spejderlasse/IOT/README.md

# IOT
Internet Of Things

## Purpose
Repository for the course E5IOT at Aarhus University, 2020.
This repository will contain sourcecode for the IOT project of Lasse Greve Rasmussen.
The project will be developed for a particle Argon.
The project is targeted a hen house, and the purpose is to set up a device to controle the gate  .

## Structure
There is two folders. One for the code, and one for appendixes.

## Tasks
- collect daily sunrise/sunset from an online service.
- by a servo close the door one hour after sunset.
- by a servo open the door at sunrise.
- allow a user to manually open or close the door.

## Documentation
The documentation will be in danish.

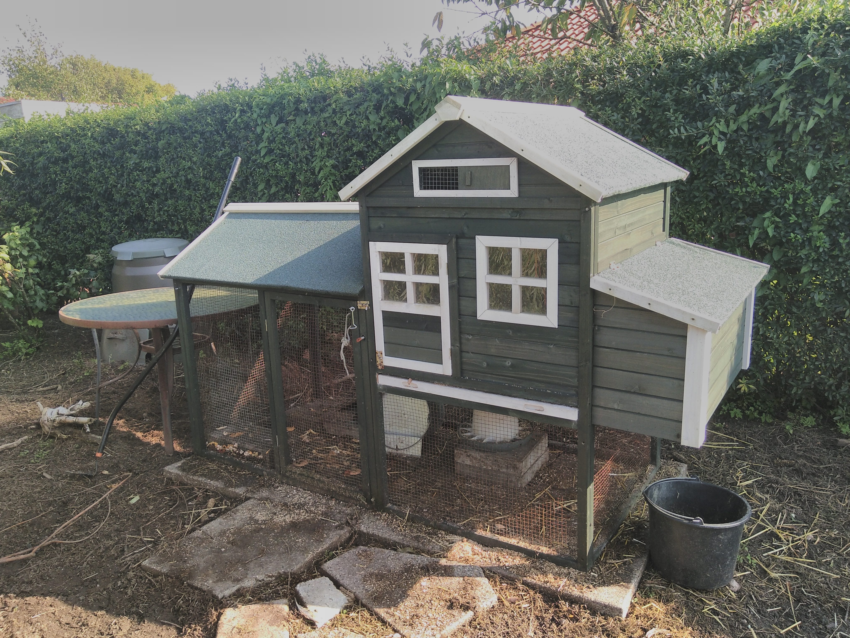
[picture p1: IMG_20200914_155222.jpg]


## Video Demonstration
https://youtu.be/oadeA-ce4zg
