spejderlasse/IOT/IOT_Dokumentation_01.docx

# E5IOT

# Internet of Things

# Automatisering af hønsehus

5. semester 2020

Science and Technology, Ingeniørhøjskolen, Aarhus Universitet, EDE, Herning

Deltagere
Studienummer | Navn | | Initialer
201808044 | Lasse Greve Rasmussen | | LGR
Undervisere: Morten Opprud Jakobsen Klaus Kolle

# Resume

Denne rapport gennemgår hvordan der er arbejdet med en IoT løsning til automatisering af døren i et hønsehus.

Rapporten beskriver analyse, design, implementering og verifikation af projektet.

# Forord

Denne rapport er dokumentation for det selvvalgte projekt der er arbejdet med under faget ’E5IOT’ der omhandler begrebet ’Internet Of Things’.

Hvem er jeg:

Lasse Greve Rasmussen

Uddannelsessted: Aarhus Universitet, Herning

Studieretning: Ingeniør - Elektronik

Semester: 5. semester

Underviser: Morten Opprud Jakobsen

Afleveringsdato: december 2020

Bedømmelsesdato: december 2020

## Begreber og forkortelser

Begreb | Definition
hønsehus | Hønsehuset består af selvehønsehuset samt en tilhørende lille hønsegård. Det er hele denne enhed der lukkes og åbnes for
Argon | Udviklingsboard fra Particle
IFTTT | Online service ‘If This Then That’ [05]

# Indledning

Formålet med denne opgave er at undersøge, hvordan man kan lave en internetforbundet løsning der automatiserer døren i et hønsehus. Løsningen skal kunne åbne døren ved solopgang, og efter solnedgang skal den lukke døren igen.

Høns er meget pålidelige i at de altid søger ind i deres hus når det begynder at blive mørkt. Det er derfor ikke nødvendigt at kontrollere om hønsene er inde, når blot man sikrer at lågen først lukkes efter at det er blevet mørkt.

Formålet med at holde hønsehuset lukket om natten, er at sikrer at der ikke kommer skadedyr i hønsenes foder.

Systemet skal være baseret på data om dagens solopgang og solnedgang der ligger online, så enheden der styrer systemet skal være forbundet til internettet.

# Analyse

For at klarlægge hvad systemet skal kunne er der lavet krav der definerer dette. Kravene er kategoriseret og formuleret efter EARS metoden.

## Krav

ufravigelige

- Systemet skal kontrollere en servomotor der kan åbne og lukke døren i et hønsehus.
- Systemet skal have informationer om solopgang og solnedgang via internettet.

Handling

- Når solen er stået op, skal lågen åbne.
- Når solen er gået ned, skal lågen lukke.

Tilstand

- Mens systemet ikke har nogle funktioner, skal systemet bruge så lidt strøm som muligt.

Uønsket adfærd

- Hvis der ikke er wififorbindelse, skal systemet styres ud fra lysmålinger målt med en photoresistor.

Valgfri

- Systemet kan indeholde styring af belysning i hønsehuset
- Systemet kan være drevet af et batteri der om dagen oplades af en solcelle

## Platform

Projektets krav til platform

- Minimum én ADC til photoresistor.
- Minimum én PWM udgang til at kontrollere servomotoren.
- Mulighed for internetforbindelse via WiFi.
- Systemet stiller ikke store krav indenfor proces og ressourcer.

Til faget er der anvendt en particle argon, der er en god platform med mange muligheder til IOT løsninger. Det vurderes at denne platform vil være god til projektet, da den overholder ovenstående krav til en platform.

I Figur 1 ses et overblik over en Particle Argon. Her ses at der er flere muligheder for både PWM og ADC, og boardet kan forbinde til internettet via WiFi. Particle Argon bygger på en 64MHz ARM Cortex-M4F 32-bit processor og har 1 MB flash, og 256 KB RAM [3]. Dette er rigeligt til de relativt simple opgaver der skal løses i dette projekt.


Figur 1 - pinout for Paricle Argon [03]

# Design

I dette afsnit vil de overordnede tanker om systemets design være beskrevet.

## modes

Systemet bygges op omkring tre modes;

- Normal: systemet afventer funktionskald fra IFTTT eller interrupt for manuel kontrol. Mens systemet er i normal, vil en tæller stå og tælle op. Hvis der går 20 timer uden kald fra IFTTT, antages det at der er sket en fejl, og systemet går i ’sensor control’.
- Sensor mode: dette er et sensorstyret mode, der fungere som fejlhåndtering. Systemet måler via photoresistor lysstyrke, og baseret på en midlet værdi vurderes om lågen skal åbnes eller lukkes. Dette fortsætter indtil der er blevet gennemført et online funktionskald.
- Manual mode: Med to trykknapper kan man manuelt åbne eller lukke lågen, hvis dette gøres, forbliver systemet i ’manual mode’ indtil en tredje trykknap for ’manual mode off’ aktiveres.

## Feedbacksignaler

For at give brugeren feedback er koden implementeret så forskellige farver viser hvilket mode der er aktivt.

- Normal: dioden lyser grøn som det er vist på Figur 8.
- Sensor control: dioden lyser rød for at indikere at der er ’fejl’ i systemet. Dioden lyser ikke konstant, da den vil være slukket under måling af lysniveau.
- Manual: dioden lyser blå.

## Aktivitetsdiagram

For at klarlægge handlinger i systemet laves der et aktivitetsdiagram. Aktivitetsdiagrammet består af en blanding af almindelige processer, og interrupt tyrede processer.


Figur 2 - aktivitetsdiagram

## Interface

Her ses det hvordan komponenterne i systemet skal forbindes.


## styring efter solopgang og solnedgang

For at styre lågen efter solopgang og solnedgang vælges det at anvende to services fra IFTTT.com. IFTTT står for If This Then That, og er en samling af mange services særligt til anvendelse for IOT enheder. Funktionerne kan kombineres, så man på baggrund af en hændelse kan få udført en anden.

Til at detektere solopgang og solnedgang anvendes services fra ’Weather Underground’ der giver signal ved henholdsvis solopgang og solnedgang. For solnedgang sættes lokationen til Dublin, for at sikre at alle hønsene når at komme ind. Indstillinger for sunset ses i Figur 3.

Particle har også en service der giver mulighed for at kalde en funktion på f.eks. en argon. Indstillinger for funktionskald ses i Figur 4.


Figur 3 - If -> sunset | Figur 4 - Then -> kald 'gate' med argumentet close

## Energiforbrug

For at systemet potentielt skal kunne drives af et batteri, er det vigtigt at det har et lavt strømforbrug. Den enhed der har det største strømforbrug er servomotoren. Målinger foretaget med 1 ohms modstand i serie med 5V forsyning (Figur 5), viser at denne kan have et forbrug på op mod 550 mA.

Et billede, der indeholder tekst Automatisk genereret beskrivelse

Figur 5 - opstilling til måling af systemets samlede strømforbrug

Servomotoren vil fast have dette høje strømforbrug, idet den konstant vil forsøge at fastholde sin position i target. Den eneste måde at stoppe dette er at afbryde forsyningen. Der sættes derfor en transistor som forbindelse mellem servomotorens stelledning, og GND på boardet. Denne transistor aktiveres af en GPIO sat som digitalt output.

Der vælges en BD135 NPN transistor der bl.a. har følgende egenskaber:

- Den kan trække op til 1.5 A på collector benet.
- Den har en forstærkning på mindst 25.
- BaseEmitter spænding op til 1 V

For at kunne trække en strøm på op til 600 mA med transistoren i satuation, skal base strømmen altså være mindst (550mA)/25=22 mA

Spændingsfald over basemodstanden vil mindst være 3.3V-1V=2.3 V

Dermed giver det en modstand på (2.3 V)/(22mA)= 104.5 Ω

Der anvendes en 100Ω modstand mellem D2 og basen på transistoren som det ses i Figur 6.

Se appendix ap02 for datablad over transistor BD135.


Figur 6 - styring af stelforbindelse via transistor

## Sleep mode

For at spare på strømmen undersøges det om enheden kan puttes i sleep, når den ikke har noget at foretage sig. Der er tre sleep modes der skal vælges mellem. De tre er ’Stop’, Ultra Low Power’ og Hibernate.

Kriterier for valg af sleep

- Der er ikke behov for ofte at vågne op, så forbrug ved opvågning har ikke den store betydning.
- Den største del af tiden har enheden ingen funktioner, så der ønskes et sleep mode med meget lavt forbrug.
- Skal kunne styres af funktionskald gennem Wifi
- Skal kunne styres af gpio.
- Der kan muligvis blive behov for at arbejde videre med variabler.

| Kan styres af GPIO | Kan styres af RTC | Kan styres af wifi | Forbrug ned til | Gemmer variabler
Stop | Ja | Ja | Ja | Ca. 400 µA | Ja
Ultra Low Power | Ja | Ja | Ja | Ca. 80 µA | Ja
Hibernate | Ja | Nej | Nej | Ca. 65 µA | Nej

Tabel 1 – funktioner i forskellige modes af sleep [02]

Ud fra denne sammenligning virker det oplagt at vælge Ultra Low Power, der ligger langt under forbruget i ’stop’, men som stadig har de funktioner der skal anvendes.

Ud fra tabellen på Figur 7 ses det dog at strømforbruget ikke nødvendigvis bliver meget lavere, når wifi skal være slået til som wakeup mulighed under sleep.


Figur 7 - tabel over strømforbrug fra datablad [03]

For at blive klogere på det reelle strømforbrug er 8 forskellig configurationer af sleep afprøvet. Dette kan ses i appendix 01 på github [01].

Konklusionen er at det ikke at der ikke kan findes et sleep mode som kan vækkes via online funktionskald. Der er i øvrigt ikke den store strømbesparelse at hente når wifi fortsat skal være slået til. Der anvendes derfor ikke sleep i implementeringen.

# Implementering

I dette afsnit vises hvordan systemet er implementeret.

## hardwareopbygning

Kredsløbet er bygget op på et veroboard hvor forbindelser er loddet sammen på bagsiden. To rækker pinheaders er placeret, så man nemt kan montere en particle argon i midten. Photoresistoren er også monteret i pinheaders. Dette giver en mere fleksibel løsning så man f.eks. kan isætte ledninger, og føre dem ud til et andet sted hvor photoresistoren kan monteres.


Figur 8 - opbygning af kredsløb på veroboard

Veroboardet er placeret i et afskærmet rum inde i hønsehuset. Der er vinduer ud for rummet, så photoresistoren kan måle lysstyrken når den er monteret direkte på boardet.

Servomotoren er forbundet via stænger til lågen.

Systemet er som udgangspunkt forsynet med 5 V gennem USB.

## kode

Den implementerede kode kan findes på github [01]

# Verifikation (LGR)

Under tilpasning og test er particles online consol anvendt [04]. Herfra er det muligt at lave online funktionskald tilsvarende dem der kommer fra IFTTT. Desuden kan man overvåge events og udlæse variabler der er gjort tilgængelige. Particles online consol giver et godt billede af hvad der sker lige nu, men da styringen gerne har skulle testes over flere døgn for at kunne indstille lysniveau, har der også været anvendt thingsspeak.com. Her er der oprettet to grafer der løbende plotter lysniveau og lågens position [06] [07], der ses to eksempler på dette i Figur 9. Thingsspeak har givet et rigtig godt overblik til både tilpasning og test.

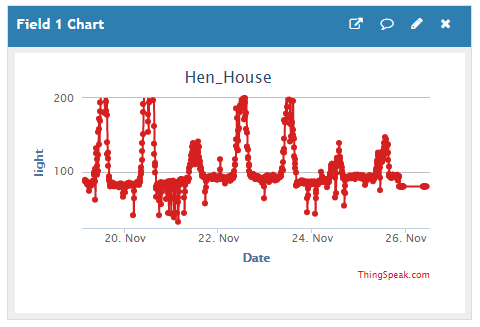
[picture p24: figure]

Figur 9 - graf fra thingsspeak der viser lysniveauet over flere døgn

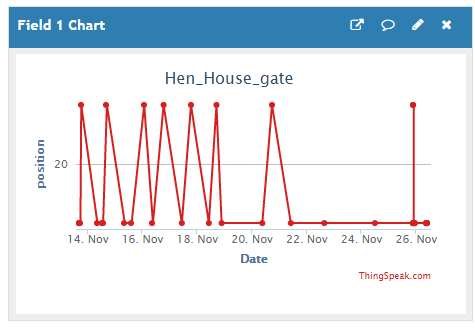
[picture p25: figure]

Figur 10 - eksempel på at lågen har fungeret i en periode, men at noget derefter er gået galt

## Test

Her er test af systemet beskrevet punktvist. Testen udføres ved ’skrivebord’ og hastigheden i koden sættes op, da det er tidskrævende at udføre reelle test fordi der kun er to hændelser om dagen.

Forklaring: positiv pwm puls på ca. 14% betyder at lågen lukkes, og ca. 2% betyder at lågen åbnes.

- koden hentes fra github [01].
- Koden ændres, så konstanten ’MAXWAIT’ sættes til 60000. Dette vil sige at systemet allerede går i sensor control efter 1 minut.
- Et scope med min to kanaler tilsluttes én kanal til 5V forsyning og stel til servomotoren, og den anden til pulssignalet til servomotoren, og det andet til GND på boardet.
- Hvis ikke systemet er tilsluttet servomotoren kan det være nødvendigt at sætte en 100kΩ modstand ind mellem 5V og GND til servomotoren.
- Systemet tilsluttes, og flashes med den ændrede kode.

*Efter at enheden er genstartet skal RGB dioden lyse svagt grøn.

- Vent ét minut

*Efter et minut skifter RGB dioden til rød

- Forsøg ny at skærme for lyset til photoresistoren ved at holde fingrene omkring den.

*indenfor 10 sekunder skal pwm signalet gå mod en puls på ca. 2%.

- Lys i stedet på photoresistoren.

*indenfor 10 sekunder skal pwm signalets puls gå mod ca. 14%.

- Vent yderligere 10 sekunder.

*se at spændingen til servomotoren er faldet til 0V.

- Fortsæt med at holde photoresistoren oplyst.
- Via particles online consol sendes ‘open’ til funktionen ‘gate’

*pwm signalet skal gå mod en puls på ca. 2%, og efter 10 sekunder skal forsyningen til servomotoren være slukket. RGB dioden skal være blevet grøn igen.

- Efter 30 sekunder sendes ’close’ igen online, og efter yderligere 30 sekunder sendes ’open’ igen. Dette getages én gang.

*i de to minutter skal RGB dioden forblive grøn.

- Trykknappen ’Close’ aktiveres.

*det kontrolleres at pwm falder til ca. 2%, og at RGB dioden bliver blå, efter 10 sekunder skal forsyningen til servomotoren være faldet til 0V.

- Trykknappen ’Open’ aktiveres.

*det kontrolleres at pwm stiger til ca. 14%, og at RGB dioden bliver blå, efter 10 sekunder skal forsyningen til servomotoren være faldet til 0V.

- Trykknappen ’manual off’ aktiveres.

*RGB dioden bliver igen grøn

Vurdering af test:

Hvis disse betingelser markeret med * er opfyldt, er testen godkendt

## Resultat

Testen som er udført ved ’skrivebord’ med scope på Analog Discovery. Testen er gået godt, og alle betingelser er opfyldt. Uddrag fra test ses i Figur 11, Figur 12, Figur 13 og Figur 14.


Figur 11 - efter online funktionskald 'open' bliver PosDuty kortere


Figur 12 - Efter fem sekunder er forsyningsspændingen faldet


Figur 13 - efter online funktionskald 'close' bliver PosDuty længere


Figur 14 - Efter fem sekunder er forsyningsspændingen faldet

# Konklusion

Der er gennem projektet fundet en løsning der i høj grad løser de krav der var stillet til opgaven.

Der er til opgaven anvendt en Particle argon, som har vist sig at være meget fleksibel at arbejde med til cloudløsninger. Der er gennem projektet anvendt online services til at udføre online funktionskald, logge data, og overvåge variabler og events. De anvendte services har i høj grad været forberedt til enheder fra Particle. Jeg ville bestemt overveje Particle argon til min næste internetforbundne dims.

Der er arbejdet med optimering af strømforbrug. Bortset fra at en høj standbystrøm til servomotoren er fjernet, så har det været svært at optimere på strømforbruget. Så længe enheden skal være forbundet til internettet via wifi, vil der være et forbrug på mindst 30mA - 40mA. Dette kan være en udfordring hvis man ønsker at lave en løsning der er forsynet fra et batteri.

Som løsning kunne man overveje at lægge initiativet til internetkommunikation hos enheden selv. På den måde kan wifi slukkes, når ikke enheden vil kommunikere. Dette kunne gøres hvis man stedet for et online funktionskald, anvendte et API kald fra enheden selv.

# Referenceliste for samlet dokumentation

Id | Beskrivelse | Reference
[01] | Github til projektet | https://github.com/spejderlasse/IOT
[02] | Paticle reference manual | https://docs.particle.io/reference/device-os/firmware/argon/
[03] | Particle datablad | https://docs.particle.io/datasheets/wi-fi/argon-datasheet/
[04] | Particle online consol | https://console.particle.io/devices
[05] | If This Then That | https://ifttt.com
[06] | Things Speak, gate status | https://thingspeak.com/channels/1194001
[07] | Things Speak, lightlevel | https://thingspeak.com/channels/1192992
[08]
[09]
[10]
[11]
[12]
[13]
[14]
[15]
[16]
[17]

# Bilag

Lasse Greve Rasmussen E20 – E5IOT, 5. Semester 2020 Page 1 of 47
