spejderlasse/IOT/IOT_præsentation.pdf

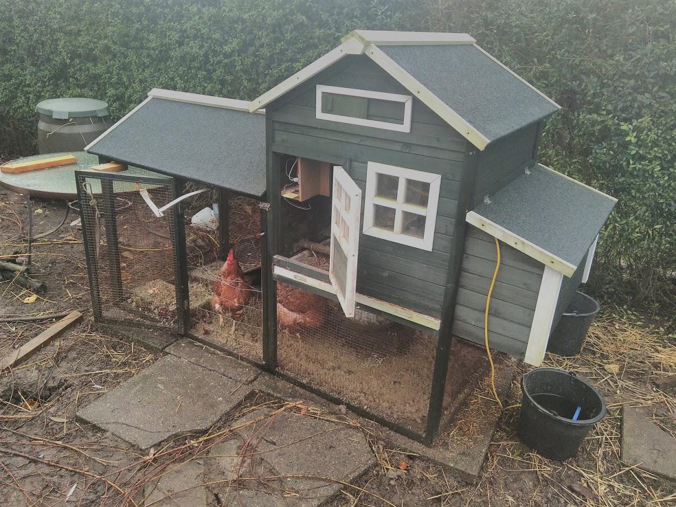
[picture p28: page 1]

## E5IOT

## Automatisering af Hønsehus

Lasse Greve Rasmussen

# Agenda

- Præsentation af løsning
- Udviklingsarbejdet med brug af online værktøjer
- Alternativ til online funktionskald
- API
- MQTT
- spørgsmål

# Præsentation af løsning

- Introduktion til opstilling
- Sensor kontrol
- Rød diode blinker
- Åbner/lukker baseret på lysniveau
- Manuel kontrol via trykknapper
- Blå diode lyder
- Normal
- Skifter til normal ved online funktionskald

# Udvilkling med online værktøjer

- Particle online værktøjer
- Cloud flash
- Consol
- Administrering af webhooks
- IFTTT
- Enkelt opsætning pålidelig service
- Thingsspeak
- Godt overblik over data
- Mulighed for at arbejde videre med csv. Fil i f.eks. matlab

- API
- Udklip fra JSONstreng

# API som alternativ til online funktionskald

Min API nøgle

Breddegrad, længdegrad

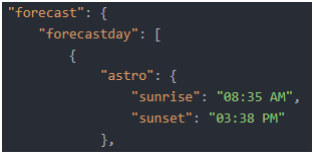
[picture p29: figure]

void loop(){
if(UpdateSunTimes()==0)
{
SensorControl();
}
else
{
sleep(CurrentTimeUNIX()-SunriseUNIX()); OpenGate();
sleep(CurrentTimeUNIX()-SunsetUNIX()); CloseGate();
sleep(CurrentTimeUNIX()-NextDayUNIX()); }
}

- Opsætning af MQTT broker
- QOS:1 At Least Once
- Retain: true

# MQTT som alternativ til online funktionskald

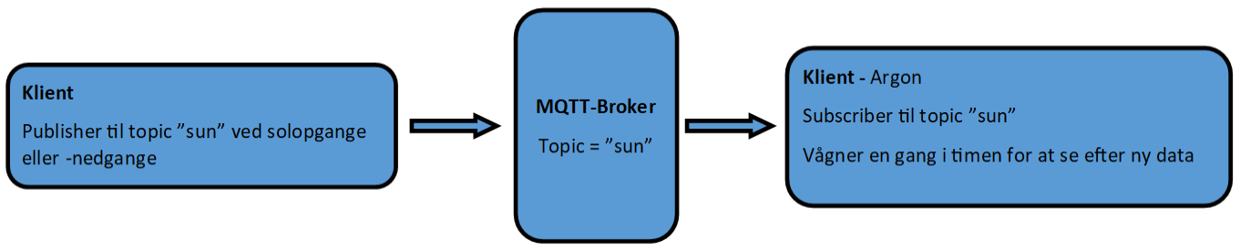
[picture p30: figure]

# spørgsmål

# OSI modellen

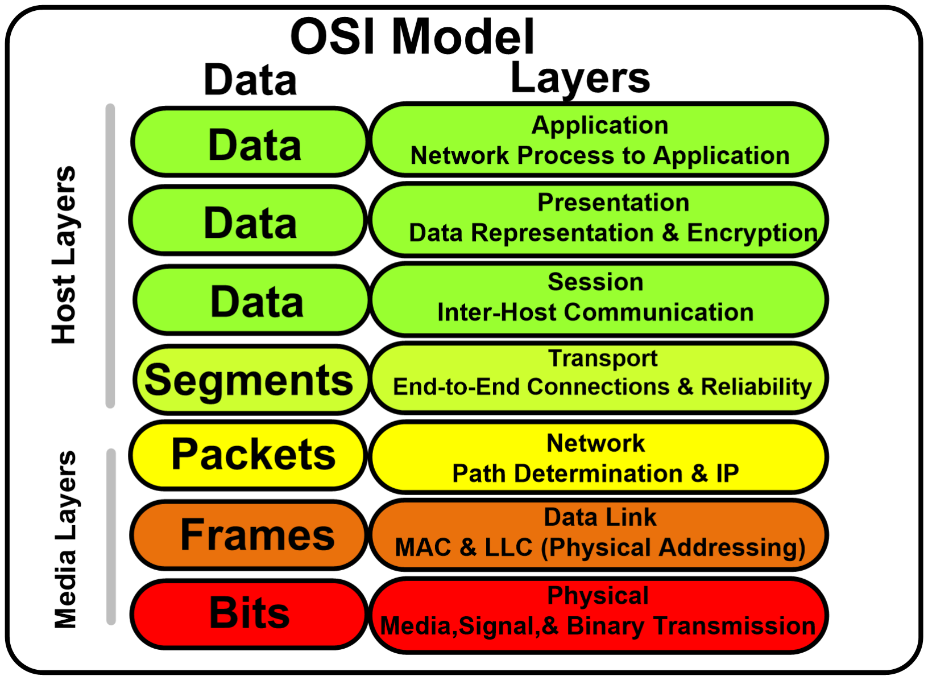
[picture p31: figure]

https://electricalacademia.com/computer/osi-model-layers-functions/

# UDP TCP

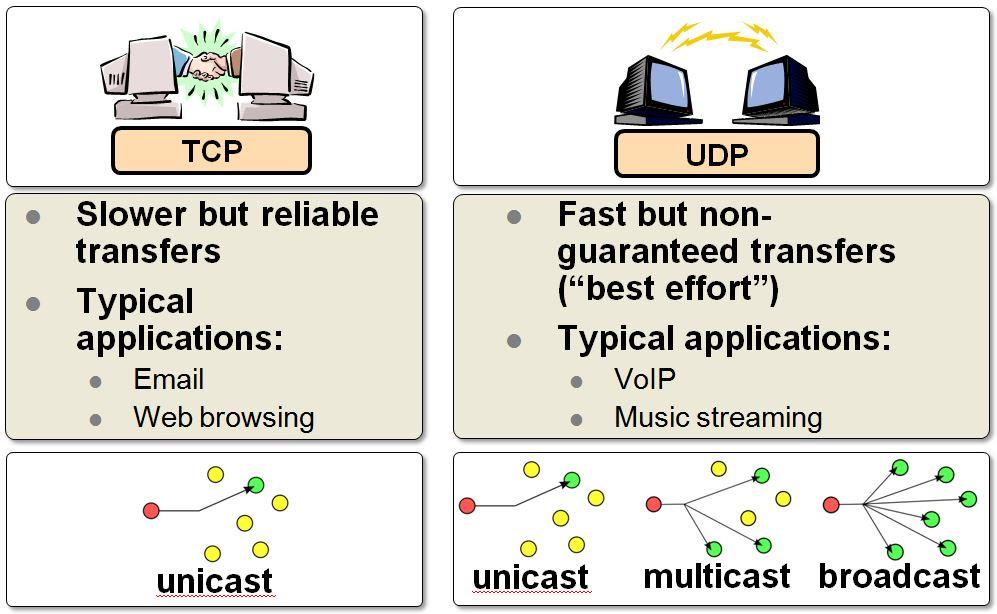
[picture p32: figure]

https://microchipdeveloper.com/tcpip:tcp-vs-udp
